adityapeketii/Audio-Amplifier/2024122001_2024122003_EW_Project1_Report.pdf

# Electronics Workshop Project - 1

# Audio Amplifier

Course Code: EC2.202
Term: | Spring Semester 2025
Team: | Aditya Peketi,
| 2024122001 peketivenkata.v@research.iiit.ac.in
| Somish Singh Nol ,
| 2024122003 somish.nol@research.iiit.ac.in
Date: | 4 March 2025

## Overview of the Project

The objective of this project was to design an audio amplifier which takes in a sound input via a mic and amplifies it to suitable level to drive an 10Ω load, within a power budget of 1.5W

## Project Specifications –

1. Supply Voltage = -5 V to 5 V
2. Input small signal voltage = 10–20 mV peak-to-peak
3. Gain = G1 × G2 ≥ 500 (Pre-amp and Gain stage)
4. Frequency = Audible Range (20 Hz to 20 kHz)
5. Power ≥ 1.5 W
6. Filter should not attenuate the input signal
7. Power Amplifier should not provide voltage gain
8. Load = 10 Ω

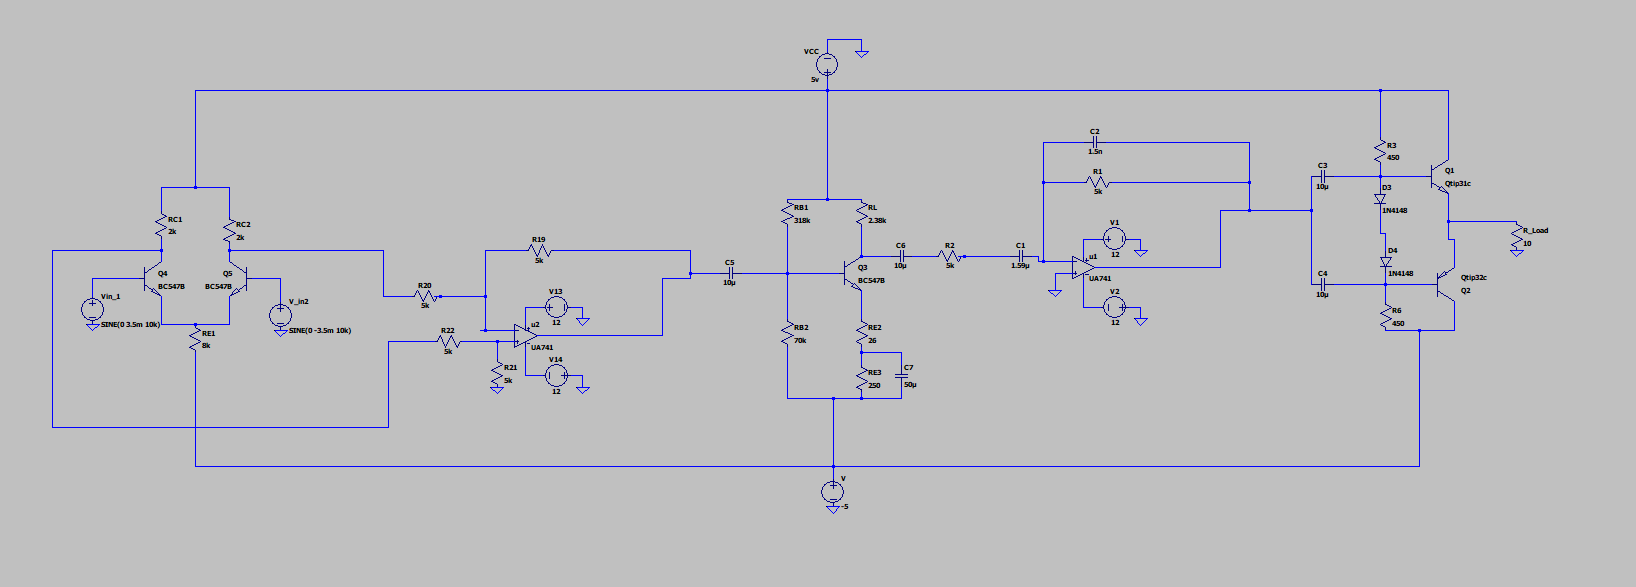
[picture p1: figure]

Figure 1: Amplifier Schematic - LTSpice

1

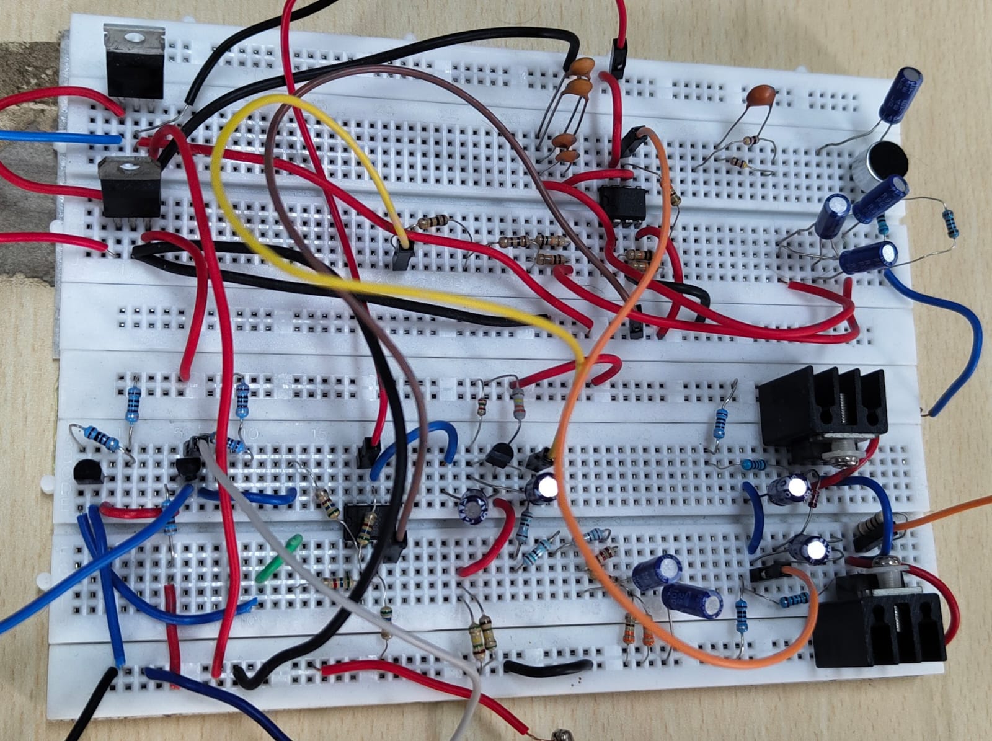
[picture p2: figure]

Figure 2: Hardware Implementation

The performance of an audio amplifier is based upon 4 major parameters:

- Frequency Response
- Noise
- Gain
- Distortion

This Project consists of 4 main stages. The first stage is the pre-amplifier which provides a minimal gain. The purpose of pre-amp is to eliminate noise. The second stage is the common emmiter amplifier (CE amp) stage which provides us the necessary voltage gain. The third stage is a band pass filter with a cuttoff frequency of 20Hz and 20kHz and the fourth stage is a class AB Power amplifier used to achieve the necessary power levels.

2

## 1 Pre-Amplifier

The input electrical signal cannot be directly fed into the common-emitter amplifier or power amplifier, as this would result in excessive noise, making it unsuitable for driving the load (speaker). Therefore, the signal must first be amplified to a sufficient level to withstand noise and reach line level. This is achieved in the pre-amplifier stage.

A pre-amplifier should have a high input impedance to minimize the current required for sensing the input signal and a low output impedance to prevent voltage drops at the output. This stage, known as the pre-amplifier stage, is implemented using a differential amplifier in a single-ended, unbalanced output configuration, where one input is connected to the microphone and the other is grounded.

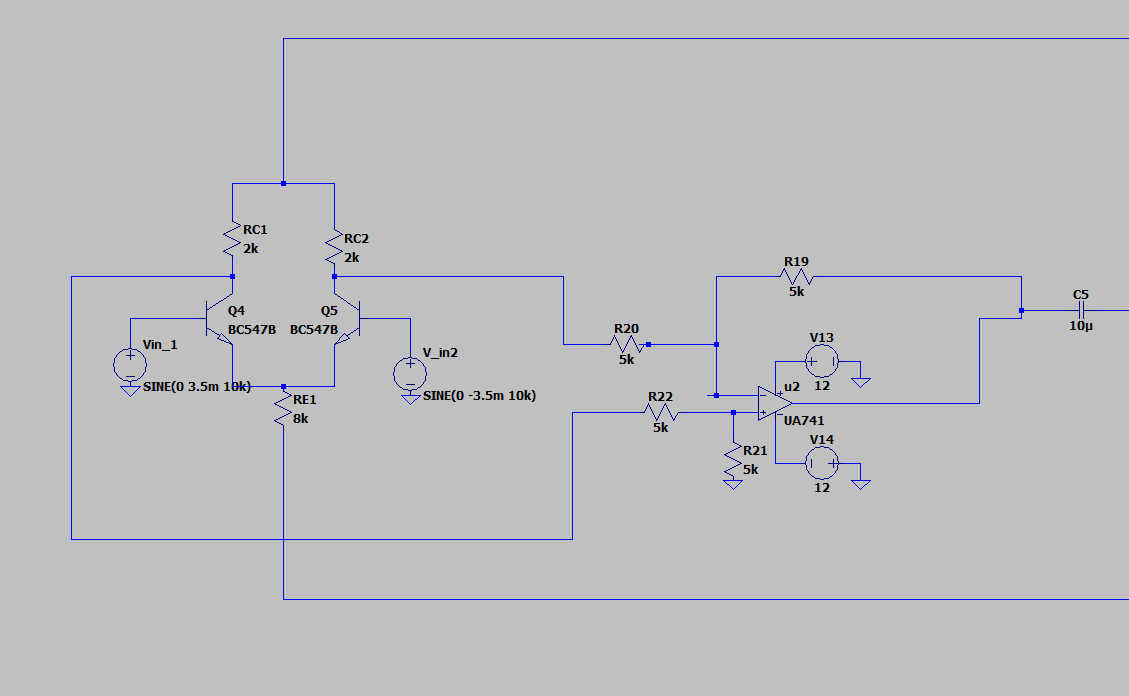
[picture p3: figure]

Figure 3: Differential Amplifier Schematic

The differential amplifier de-noises and amplifies an input signal of amplitude 10mV - 20 mV pp to an output signal of amplitude 140mV - 280mV pp, which is a gain of 14, close to the simulation gain of ≈ 15.

3

DC Analysis

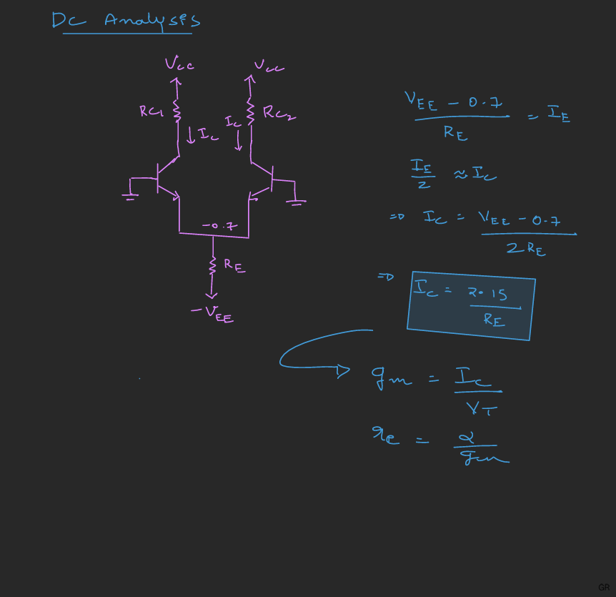
[picture p4: figure]

Figure 4: DC Analysis

4

AC Analysis:

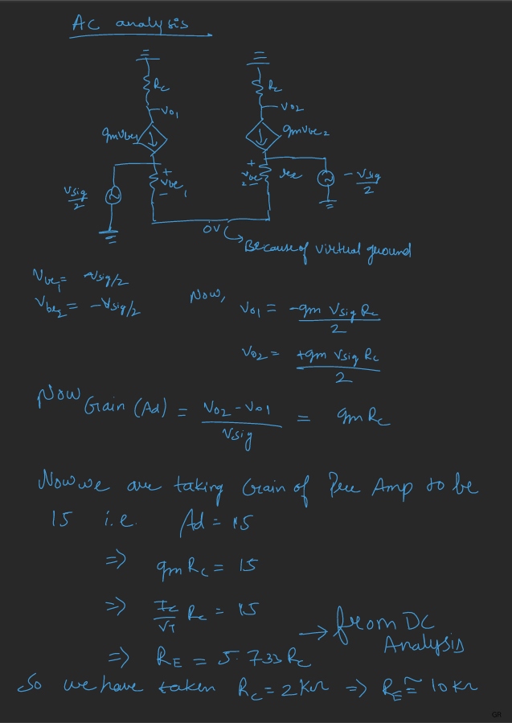
[picture p5: figure]

Figure 5: Differentaial Amp Small Signal Analysis

5

Common Mode Rejection Ratio CMRR The CMRR is found using:

CMRR = 20 log
Ad
Ac

For our Differential Amplifier, the common mode gain is Ac = 39.4 × 10⁻⁶ and the differential gain is Ad = 15. The Common-Mode Rejection Ratio (CMRR) is given by:

CMRR = 20 log
Ad
Ac

Substituting the values:

CMRR = 20 log
15
39.4 × 10⁻⁶

CMRR = 20 log(380456)

CMRR = 20 × 5.58

CMRR = 111.6 dB

6

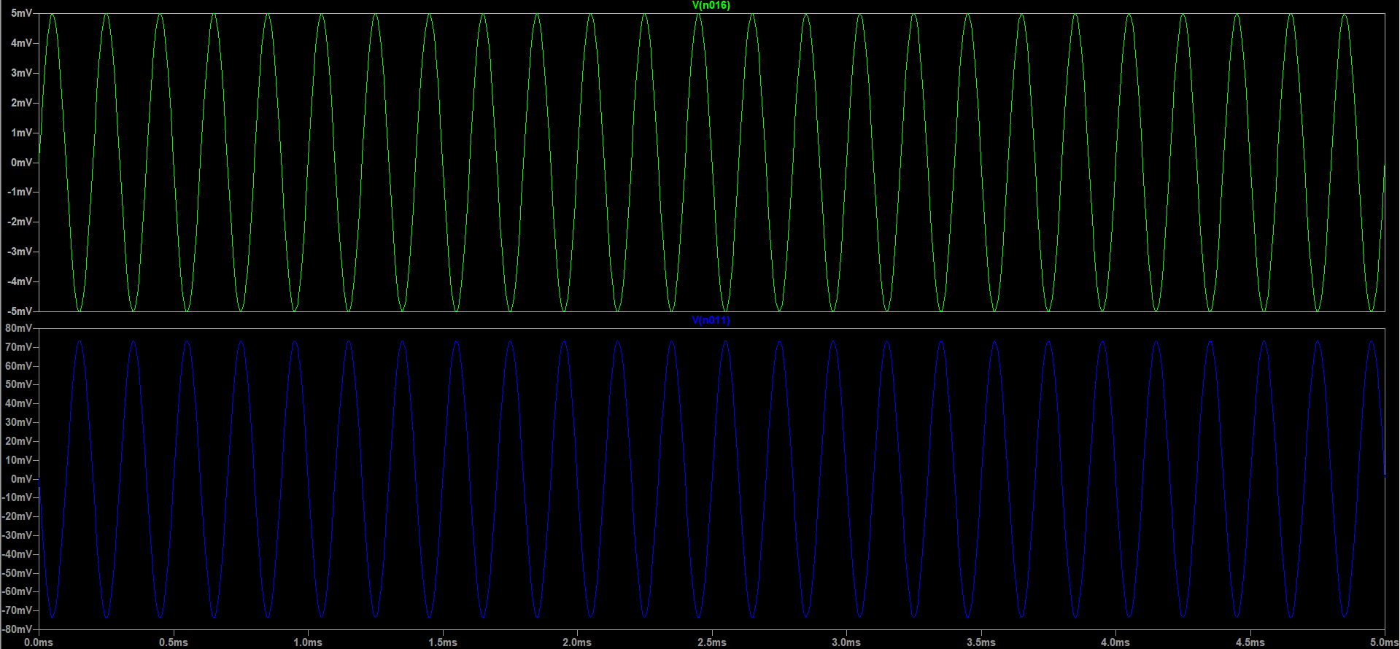
[picture p6: figure]

Figure 6: Simulation o/p for Pre-Amp stage

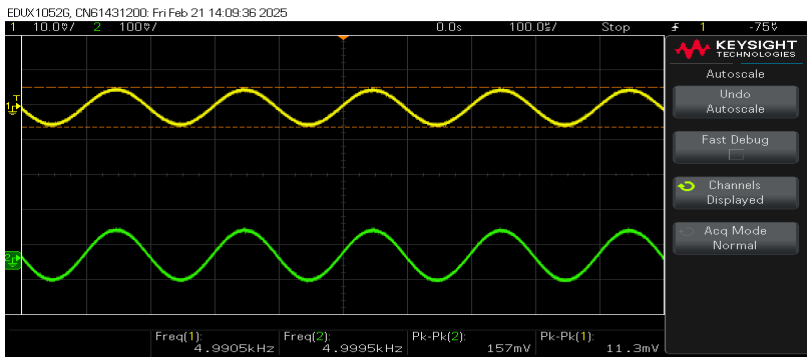
[picture p7: figure]

Figure 7: Pre Amp stage Hardware plots

7

## 2 Common Emitter Amplifier

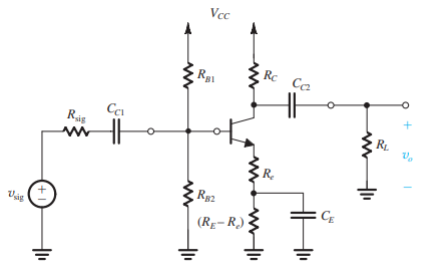
[picture p8: figure]

Figure 8: CE Amplifier

- Input Capacitor C1:
C1 is used to block the DC components of the input signal, introducing a pole into the system. Since the frequency of interest lies between 20 Hz and 20 kHz, C1 is chosen to allow frequencies below 20 kHz to pass. If C1 is too small, the low-frequency components will be attenuated, resulting in a larger bias current IB which decreases the current gain.
- Emitter Capacitor CE:
CE blocks DC current from flowing to ground.
- Coupling Capacitor C2:
C2 introduces a second pole into the system and provides AC coupling to the filtering stage.
- Biasing Resistors RB1 and RB2:
These resistors form a voltage divider with VCC to bias the transistor, ensuring that the base-emitter junction is forward biased while the base-collector junction remains reverse biased.

8

- Stability Factor:
The stability factor is given by:

S =

δIC

δICBO

VBE,β

Specifically, since
IC = βIB + (β + 1)ICBO,

differentiating with respect to IC yields:

δIC
δIC

= β

δIB
δIC

+

β + 1
S

Therefore, the stability factor can be expressed as:

S =

β + 1
1 − β

δIB
δIC

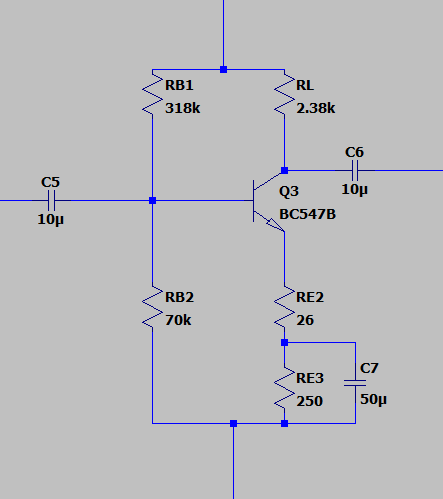
[picture p9: figure]

Figure 9: CE Amplifier Schematic

9

DC and AC Anaysis of CE Amplifier

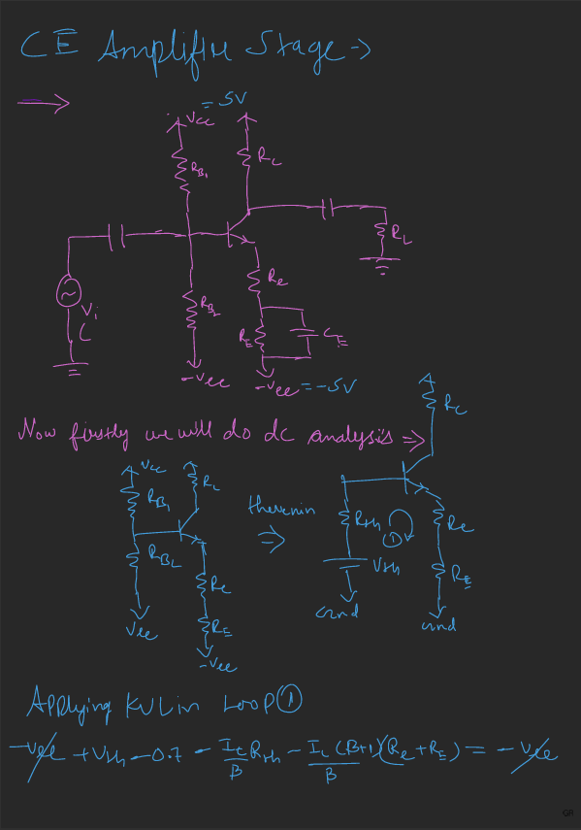
[picture p10: figure]

Figure 10:

10

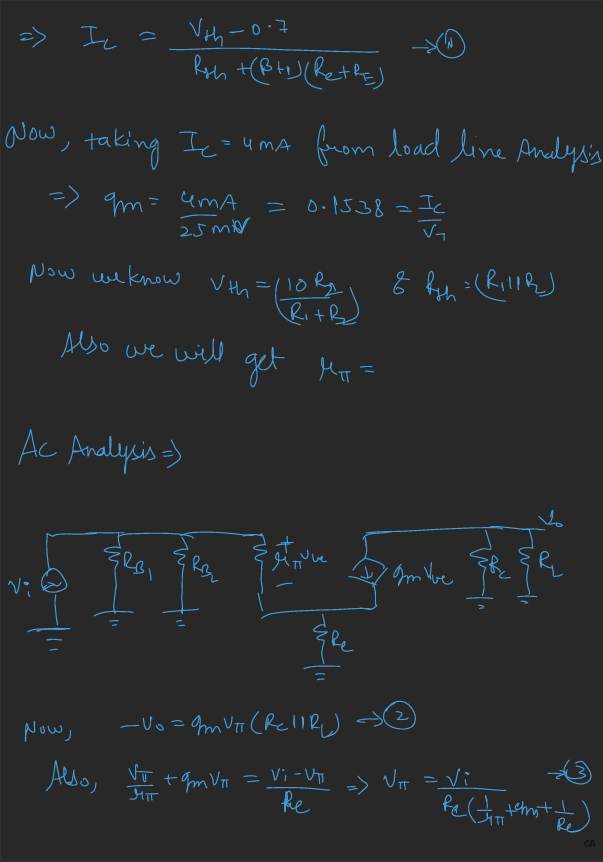
[picture p11: figure]

Figure 11:

11

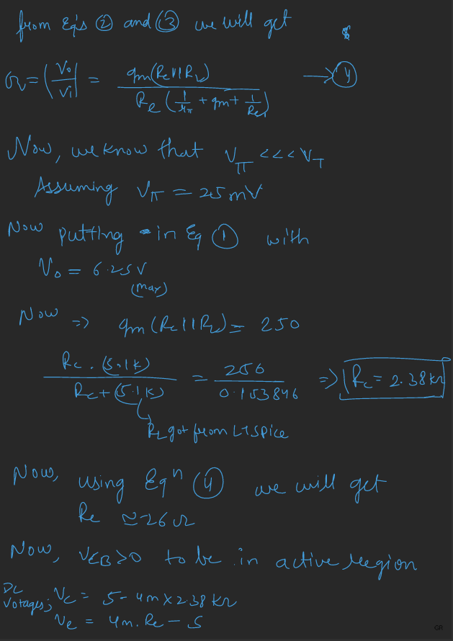
[picture p12: figure]

Figure 12:

12

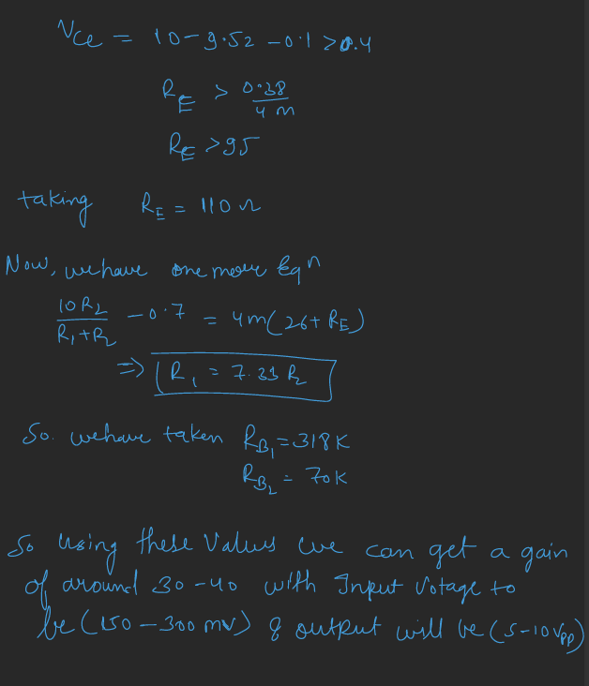
[picture p13: figure]

Figure 13:

13

This stage takes in the output of the differential amplifier (Vpp ≈ 150mV ), and amplifies it further to Vpp ≈ 5.1V , providing a voltage gain of 34 times for the CE stage.
Since, we have used a single common emitter amplifier stage, it introduces a phase shift. From the small signal model of a common emitter stage we know that its voltage gain is given by the following equation:

Gain = −

RC

1
gm

+ RE

which can be approximated as

−

RC
RE

for RE ≫

1
gm
The common emitter stage introduces a 180◦ phase shift because as the input increases i.e., the voltage at the base of the transistor increases, the current flowing through the base increases.
Since, IC = β×IB, the collector current also increases which leads to more voltage being dropped across the collector resistor and hence less voltage at the output terminal; since Vout = VCC − ICRC. This leads to an inverted output from the common emitter stage.

14

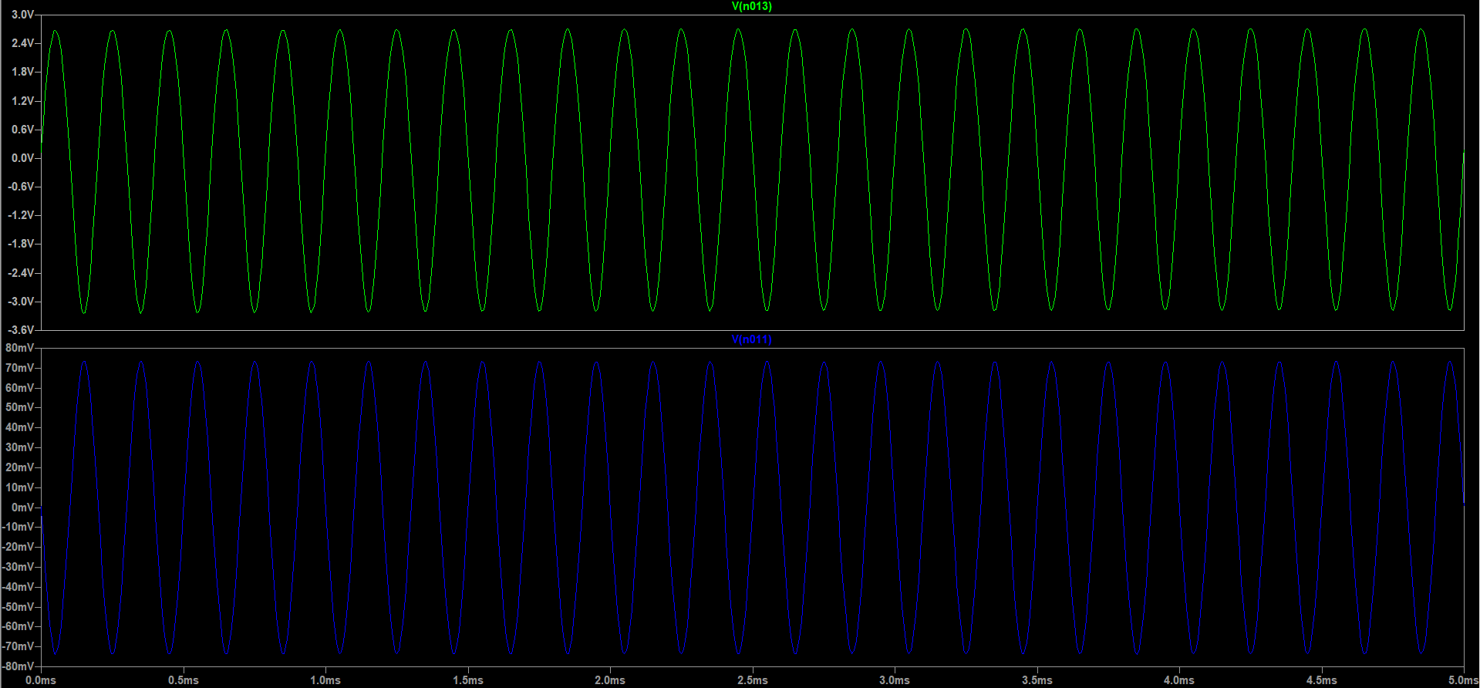
[picture p14: figure]

Figure 14: CE Amp Simulation

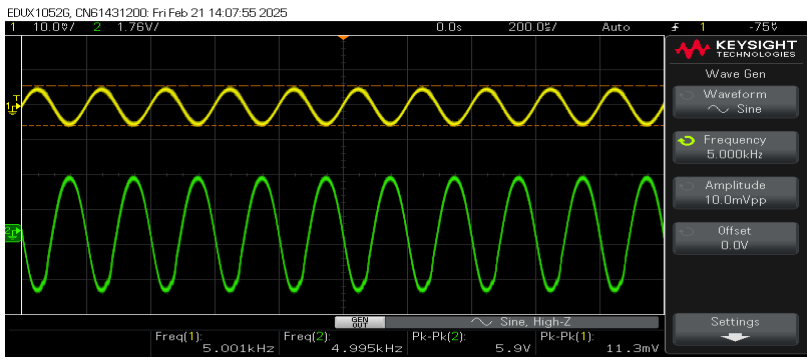
[picture p15: figure]

Figure 15: CE Amp Hardware o/p

15

## 3 Band-Pass Filter

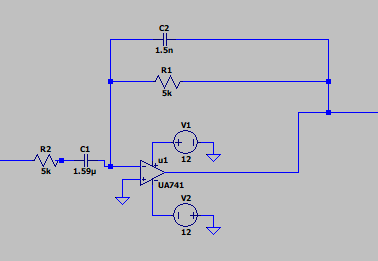
[picture p16: figure]

Figure 16: Band-Pass Filter Schematic

## Filter Stage: Band-Pass Filter Implementation

The filter stage is typically used to adjust the balance of high and low frequencies, permitting the manual adjustment of the frequency response so that we can achieve frequency-selective amplification. This stage helps eliminate unwanted noise added in the previous stage of the system and improves the overall tone.
In our implementation, we wish to keep frequencies in the range of 20 Hz to 20 kHz (which is the ideal hearing range of a human) prominent while attenuating other frequencies. To achieve this, we have implemented a band-pass filter with a low cutoff frequency at 20 Hz and a high cutoff frequency at 20 kHz.

16

### Gain of the Band-Pass Filter

The standard transfer function of a band-pass filter is given by:

H(s) = Vout(s)
Vin(s)
For the given circuit, the transfer function can be derived using impedance analysis.
1. The impedance of a capacitor is given by:

ZC =

1
sC
2. The circuit consists of a high-pass and low-pass combination. The impedance of the series capacitor and resistor at the input acts as a high-pass filter, while the feedback network acts as a low-pass filter.

The transfer function of an active band-pass filter is given by:

H(s) =

s
ω0

Q
s

2 +

s
ω0

Q + 1

where:
- ω0 = √

1
R1R2C1C2

is the center frequency, - Q =

√
R2/R1
1+R2/R1

is the quality
factor.

### Gain at Resonance

At the resonant frequency ω0, the gain of the band-pass filter is:

|H(jω0)| =

R2
R1
which depends on the resistor ratio.

### Conclusion

The active band-pass filter amplifies signals within a certain frequency range and attenuates signals outside this range. The gain at resonance is determined by the resistor ratio, while the bandwidth and center frequency depend on the resistor and capacitor values.
For a passive band-pass filter, the gain at the center frequency f0 is:

Av =

−R2
R1

17

To achieve a gain of 1, we choose:

R1 = R2 = 5kΩ

### Cutoff Frequency Calculations

The cutoff frequencies for a passive band-pass filter are given by:

fc,low =

1
2πRC1

fc,high =

1
2πRC2
where R = 5kΩ is the resistance used in both the high-pass and low-pass sections.

Solving for capacitances:

C1 =

1

2πRfc,low

=

1
2π × 5 × 10³ × 20

= 1.59 × 10⁻⁶ F = 1.59 µF

C2 =

1

2πRfc,high

=

1
2π × 5 × 10³ × 20000

= 1.59 × 10⁻⁹ F = 1.59 nF

Thus, the filter maintains a unity gain while allowing frequencies between 20 Hz and 20 kHz to pass and attenuating others.

18

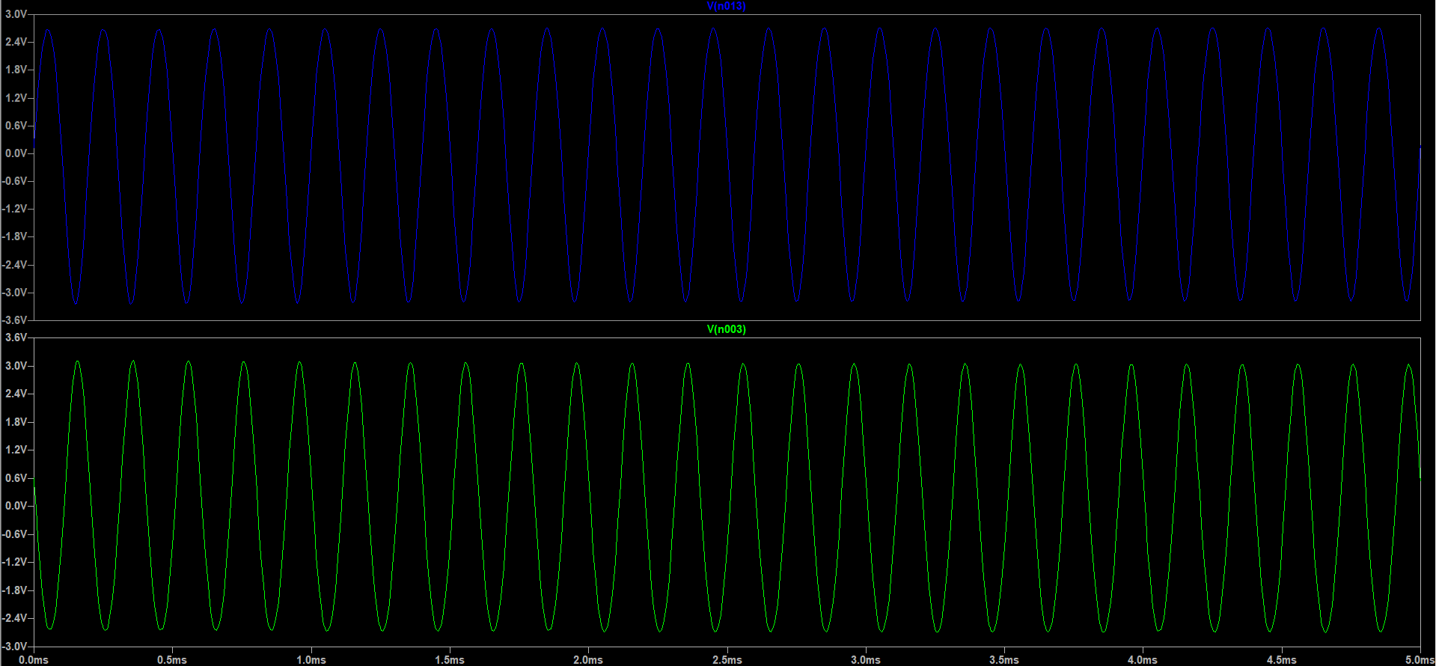
[picture p17: figure]

Figure 17: Band-Pass Filter Simulation o/p

We can see a 180 Degrees Phase shift from that of the CE Amp stage as the Band-Pass Filter has a negative gain.

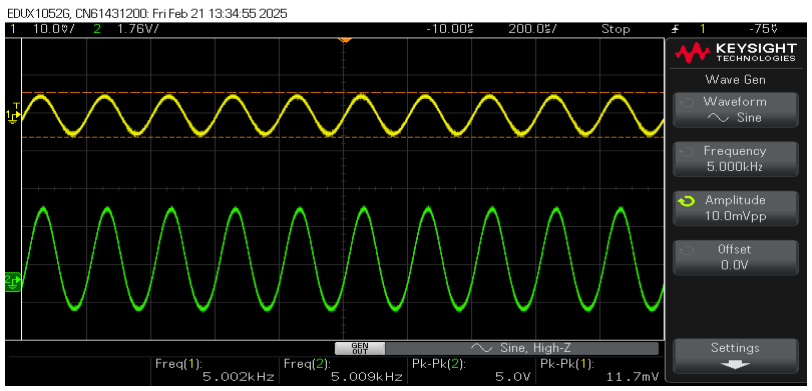
[picture p18: figure]

Figure 18: Band-Pass Filter Hardware o/p

19

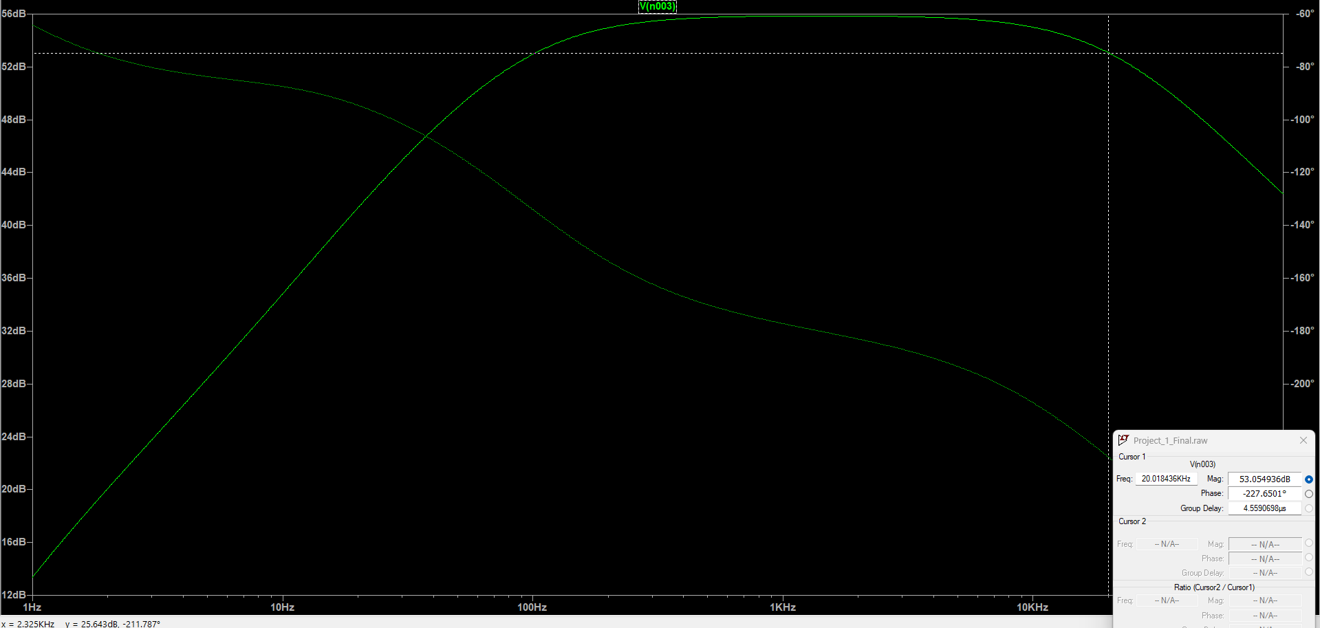
[picture p19: figure]

Figure 19: Filter Frequency response Plot - Simulation

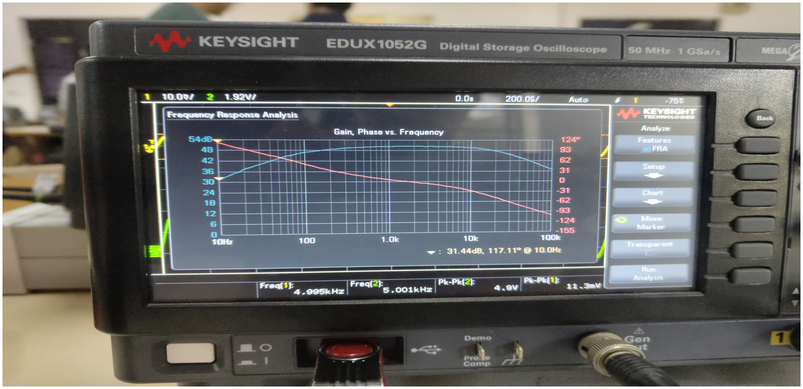
[picture p20: figure]

Figure 20: Filter Frequency response Plot - Hardware

We can see that there is a 3dB cutoff at both 20Hz and 20kHz. Therefore, this filter is designed in such a way that it passes only frequencies between 20Hz and 20kHz and rejects all the frequencies beyond the range.

20

## 4 Power Amplifier

Power amplifiers are used to increase the power level of a signal and are commonly classified intoClass-A, Class-B, and Class-AB based on their operating point, conduction angle, and efficiency.

### 4.1 Class - A Power Amplifier

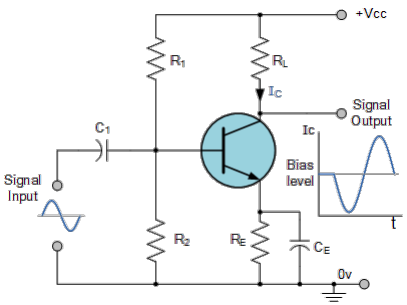
[picture p21: figure]

Figure 21: Class - A Power Amplifier

The transistor in a Class-A amplifier is biased so that it remains active (in the linear region) throughout the entire input signal cycle (360° conduction angle).

- Operating Principle of Class A Amplifier: The transistor in a Class-A amplifier is biased so that it remains active (in the linear region) throughout the entire input signal cycle (360◦
conduction angle).
- Key Features:

– High linearity, making it suitable for low-distortion amplification.

– Poor efficiency, typically around 25% – 30%.

– High heat dissipation due to continuous current flow even without input signal.

21

### 4.2 Class - B Power Amplifier

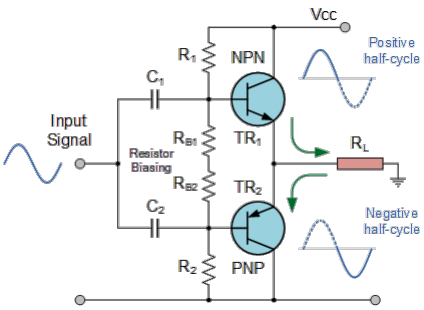
[picture p22: figure]

Figure 22: Class - B Power Amplifier

– Operating Principle: The transistor is biased at cutoff, and each transistor in a push-pull configuration conducts for half of the input signal cycle (180° conduction angle).

– Key Features:
∗ Higher efficiency compared to Class-A, typically around 60% – 70%.
∗ Introduces crossover distortion due to the transition between transistors.
∗ Requires a complementary pair of transistors (NPN and PNP or MOSFETs).

22

### 4.3 Class - AB Power Amplifier

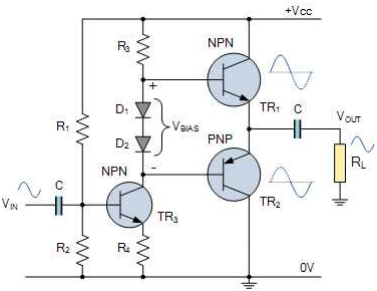
[picture p23: figure]

Figure 23: Enter Caption

– Operating Principle: Combines the features of Class-A and Class-B by biasing the transistors slightly above cutoff, allowing both transistors to conduct for slightly more than half of the signal cycle (greater than 180° but less than 360° conduction angle)

– Key Features:
∗ Improved linearity compared to Class-B, reducing crossover distortion.
∗ Higher efficiency than Class-A, typically around 50
∗ Moderate heat dissipation, balancing efficiency and linearity.

23

In our circuit we are using Class AB Power Amplifier.

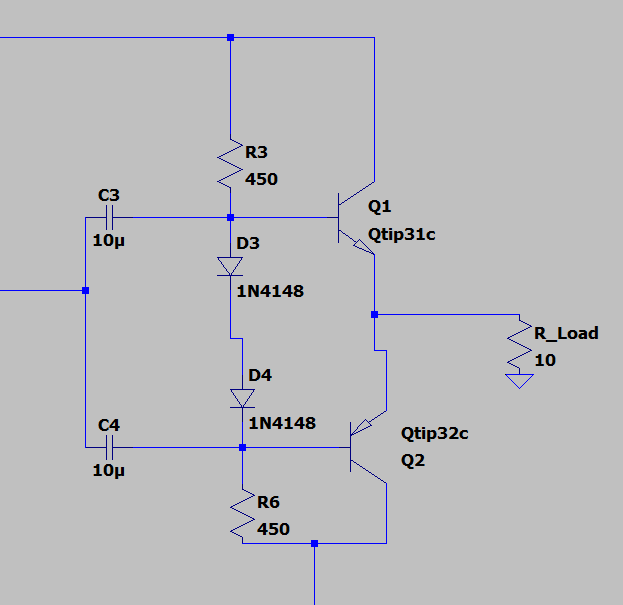
[picture p24: figure]

Figure 24: Power Amp Circut LTSpice

Note: For the power Amplifier we have used Resistance values greater than 1k(450 in the circuit Diagram here) because the the input waveform is getiing distorted as the output impedance is low.

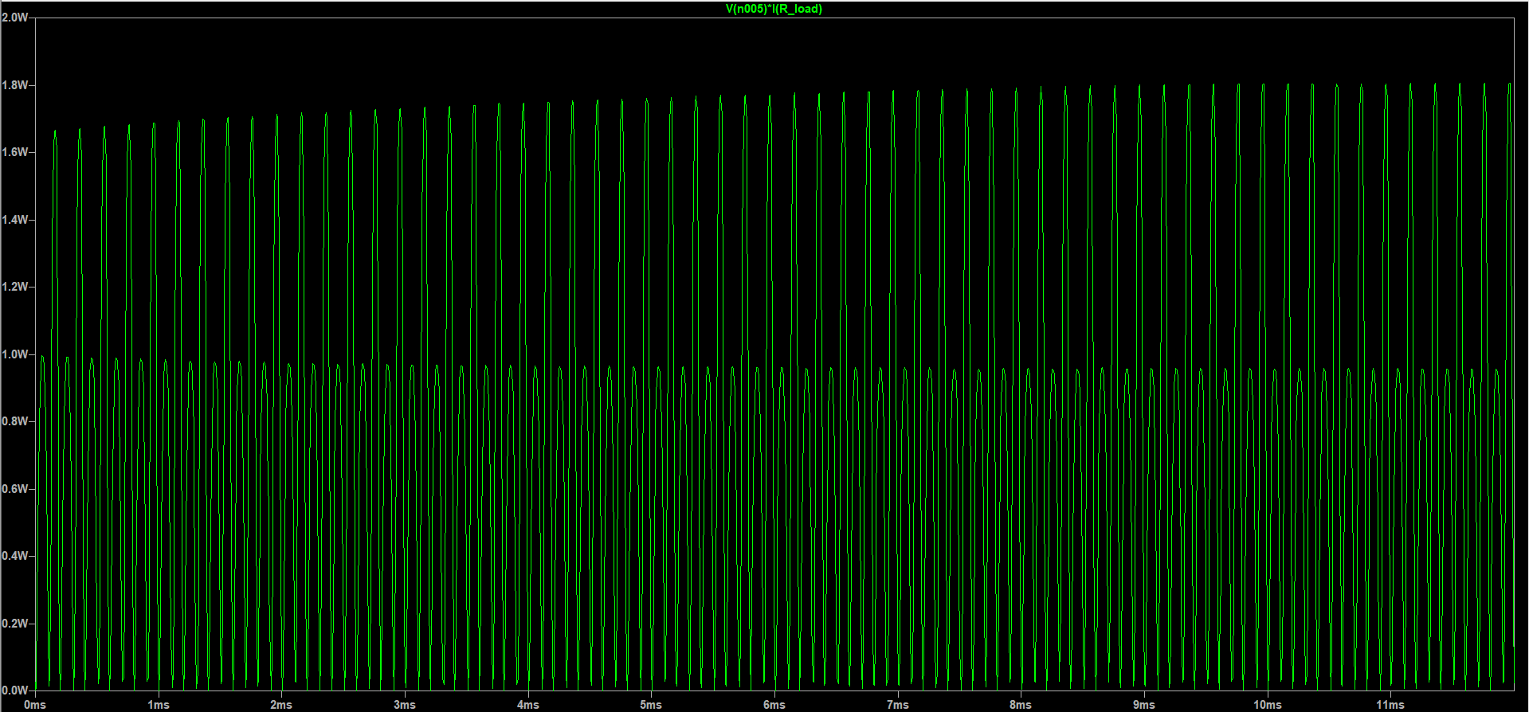
[picture p25: figure]

Figure 25: Power at the Load

We can see that we got the power output 1.5W as required.

24

MIC Circuit Used:

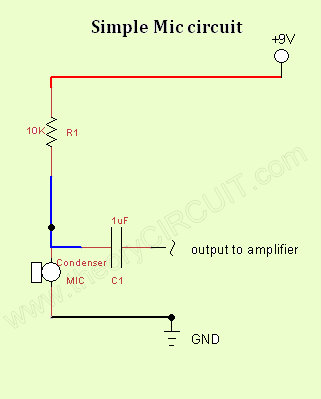
[picture p26: figure]

Figure 26: Mic Circuit

Capacitance Value Used C = 2.2 µF

Resistance Value Used R = 6.7 kΩ

25

## Distortion Analysis

Distortion analysis helps determine the unwanted harmonic content in a signal’s frequency spectrum. It provides insight into circuit behavior at different frequencies.
The total harmonic distortion (THD) is given by:

T HD =

sP∞
n=2 V

2
n RMS
V

2
f RMS

where:

– T HD is the total harmonic distortion.
– Vn RMS is the RMS voltage of the nth harmonic.
– Vf RMS is the RMS voltage of the fundamental frequency.

A high THD indicates signal distortion, which degrades audio quality. Lower THD improves signal amplification efficiency and output quality. Filters, such as resistive-capacitive (RC) networks, can reduce THD by eliminating higher-order harmonics.

## Slew Rate

Slew rate is defined as the maximum rate of change of the output voltage with respect to time:

S.R. = max
δVout

δt

A higher slew rate ensures that the circuit can handle high-frequency signals without distortion. If the slew rate is too low, the circuit may not respond quickly enough to changes in the input signal, leading to output distortion.

Slew rate can be improved by increasing the maximum operating voltage or by reducing the capacitive impedances of the circuit components.

Another expression for the slew rate is:

S = 2πfmVm, | Vm = 15mV, | f varies according to input audio.

26

## Observations

During the design and implementation of our audio amplifier, we made the following key observations:

1. Impact of Transistor Matching: A differential amplifier relies on well-matched transistors, as one of the fundamental assumptions in its analysis is that both transistors in the differential pair draw equal current. If the transistors are not closely matched, this assumption breaks down, leading to performance issues. We had to use BJTs instead of MOSFETs, which further increased mismatch issues. This problem is more pronounced in discrete components compared to integrated circuits (ICs).
2. Importance of Proper Coupling and Biasing: In discrete circuit designs, buffers and coupling capacitors are essential to prevent the output of one stage from disturbing the operating point of another. Alternatively, a DC-coupled amplifier could be implemented, but such designs are typically unsuitable for high-frequency applications.
3. Managing Thermal Runaway: Without proper heat dissipation, power amplifiers are prone to thermal runaway, which can lead to the failure of transistors, capacitors, and other components. Adequate thermal management is crucial for reliable operation.
4. Effect of Cascaded Stages on Frequency Response: Each stage in the amplifier contributes to the overall frequency response. Since the circuit consists of cascaded stages, the total frequency response is the product of individual stage responses. This can lead to undesirable frequency characteristics, making it essential to consider the high-frequency behavior of all components, not just filters.
5. Use of Voltage Regulators: The presence of voltage regulators introduces minor distortions in the output waveform. This distortion can be mitigated by using separate voltage sources for different power levels, such as a dedicated 5V supply and a separate 12V supply, to ensure cleaner power delivery.

27

## Possible Improvements

To enhance our design, we propose the following improvements:

1. Better Matched Transistors: Instead of using multiple discrete transistors, employing transistor arrays in IC packages would help mitigate mismatch issues, reduce noise, and save PCB or breadboard space.
2. Implementation of a Class-D Amplifier: Replacing the Class-AB power amplifier with a Class-D amplifier could significantly improve power efficiency. However, achieving high fidelity with a Class-D amplifier presents design challenges.
3. Higher-Order Active Filtering: Instead of using a simple firstorder passive low-pass filter, a higher-order active filter could be employed to achieve better frequency response and sharper cutoff frequencies. Additionally, an adjustable active filter could enable tone control, although trade-offs between magnitude and phase response must be considered.
4. Use of Multiple Intermediate Gain Stages: Increasing the number of gain stages can help achieve higher overall gain. Additionally, using an even number of gain stages would eliminate signal inversion introduced by those stages.
5. Utilization of Positive Feedback Loops: Incorporating positive feedback in amplifiers can enhance overall gain and help suppress noise in the system, leading to improved performance.

28
