adityapeketii/Audio-Amplifier/CE_AMP.asc

C1: cap; 10µ
C2: cap; 10µ
C3: cap; 50µ
Q1: npn; BC547B
R_Load: res; 5.1k
RB1: res; 318k
RB2: res; 70k
RE1: res; 26
RE2: res; 250
RL1: res; 2.38k
V1: voltage; -5
V2: voltage; SINE(0 72m 5k)
VCC1: voltage; 5v
Named nets: 0
.tran 5m
