adityapeketii/Audio-Amplifier/Differential_AMP.asc

-VEE: voltage; -5
C1: cap; 10µ
LOAD_CE_AMP: res; 7.2k
Q1: npn; BC547B
Q2: npn; BC547B
R1: res; 2k
R2: res; 2k
R4: res; 5k
R5: res; 5k
R6: res; 5k
R7: res; 5k
RE: res; 8k
u1: opamp2; UA741
V5: voltage; 12
V6: voltage; 12
V_in1: voltage; SINE(0 2.5m 5k)
V_in2: voltage; SINE(0 -2.5m 5k)
VCC: voltage; 5
Named nets: 0
.tran 5m
.inc "C:\\Users\\adity\\Desktop\\Final_one_bro\\UA741.301"
