adityapeketii/Audio-Amplifier/Filter.asc

C1: cap; 1.59µ
C2: cap; 1.5n
R1: res; 5k
R2: res; 5k
R_load: res; 178
u1: opamp2; UA741
V1: voltage; 12
V2: voltage; 12
Vin1: voltage; SINE(0 2.7 5k)
Named nets: 0
.tran 0 10m 3m 10u
.inc "C:\\Users\\adity\\Desktop\\Final_one_bro\\UA741.301"
