adityapeketii/Audio-Amplifier/Power_Amp.asc

C3: cap; 10µ
C4: cap; 10µ
D1: diode; 1N4148
D2: diode; 1N4148
Q1: npn; Qtip31c
Q2: pnp; Qtip32c
R3: res; 450
R4: res; 450
R_Load1: res; 10
V3: voltage; -5
V4: voltage; 5
V5: voltage; SINE(0 2.5 5k); AC 1
Named nets: 0
.tran 0 10m 5m 10u
.inc "C:\\Users\\adity\\Desktop\\Final_one_bro\\UA741.301"
.inc "C:\\Users\\adity\\Desktop\\Final_one_bro\\TIP31C.LIB"
.inc "C:\\Users\\adity\\Desktop\\Final_one_bro\\TIP32C.LIB"
;ac dec 1000 1 100k
