adityapeketii/Audio-Amplifier/Project_1_Final.asc

C1: cap; 1.59µ
C2: cap; 1.5n
C3: cap; 10µ
C4: cap; 10µ
C5: cap; 10µ
C6: cap; 10µ
C7: cap; 50µ
D3: diode; 1N4148
D4: diode; 1N4148
Q1: npn; Qtip31c
Q2: pnp; Qtip32c
Q3: npn; BC547B
Q4: npn; BC547B
Q5: npn; BC547B
R1: res; 5k
R2: res; 5k
R3: res; 450
R6: res; 450
R19: res; 5k
R20: res; 5k
R21: res; 5k
R22: res; 5k
R_Load: res; 10
RB1: res; 318k
RB2: res; 70k
RC1: res; 2k
RC2: res; 2k
RE1: res; 8k
RE2: res; 26
RE3: res; 250
RL: res; 2.38k
u1: opamp2; UA741
u2: opamp2; UA741
V1: voltage; 12
V2: voltage; 12
V13: voltage; 12
V14: voltage; 12
V: voltage; -5
V_in2: voltage; SINE(0 -3.5m 10k)
VCC: voltage; 5v
Vin_1: voltage; SINE(0 3.5m 10k)
Named nets: 0
.tran 0 10m 3m 10u
.inc "C:\\Users\\adity\\Desktop\\Final_one_bro\\UA741.301"
.inc "C:\\Users\\adity\\Desktop\\Final_one_bro\\TIP31C.LIB"
.inc "C:\\Users\\adity\\Desktop\\Final_one_bro\\TIP32C.LIB"
